AlexGershman/temp-sensor/README.md

# temp-sensor
This repo is dedicated to storing the schematic, layout, and symbol files of the temperature sensor circuit board for ECE 115D.
