AlexGershman/temp-sensor/cad/README.md

In the CAD folder, we store files such as the BOM, schematic, board, and any new symbols.
