AlexGershman/temp-sensor/sim/LTSpice/ECE_115D_555_Timer_IC.asc

A1: srflop; cycles=2
A2: inv
C1: cap; 1µ; V=16 Irms=0 Rser=0 Lser=0
C2: cap; 0.01µ; V=16 Irms=0 Rser=0 Lser=0
C3: cap; 0.01µ
C4: Cap; 10µ
E5: e; 316000
Q1: npn; QNPN_THAT_NS
Q2: npn; QNPN_THAT_NS
Q3: npn; QNPN_THAT_NS
Q4: npn; QNPN_THAT_NS
Q5: pnp; QPNP_THAT_NS
Q6: pnp; QPNP_THAT_NS
Q7: pnp; QPNP_THAT_NS
Q8: pnp; QPNP_THAT_NS
Q9: pnp; QPNP_THAT_NS
Q10: pnp; QPNP_THAT_NS
Q11: pnp; QPNP_THAT_NS
Q12: pnp; QPNP_THAT_NS
Q13: npn; QNPN_THAT_NS
R1: res; 40k
R3: res; 1k
R4: res; 1k
R5: res; 5k
R8: Res; 765
R9: Res; 500
R10: Res; 10000
R_vbe: res; 1.85k
RPTAT: res; 100
TRIG: voltage; PULSE(5 0 2m 0 0 50u 10m 3)
U1: NE555
U2: NE555
U3: AD8551
U5: AD8551
U6: AD8551
V1: voltage; 5
V2: voltage; 5
V3: Voltage; 6
V4: voltage; 5
Named nets: 0, Vbe, BG, PTAT, VCC, TRIG, THR_DISC, OUT, V_PTAT, FREQ_THR, FREQ_OUT, COUNT, V_BG, LDOout, VSW, FREQ_CTRL
.include lib/THAT_Models/300_Series_Macro_01.lib
.MODEL QNPN_THAT_NS NPN (
+ IS     = 5.005475E-15    BF     = 150
+ NF     = 1               BR     = 119.4532856 
+ NR     = 1               ISE    = 3.002016E-16    NE     = 1.3340565
+ ISC    = 3.173175E-14    NC     = 1.6525          VAF    = 60
+ VAR    = 10.8094728      IKF    = 0.2850543       IKR    = 0.0103675
+ RB      = 30             RBM     = 2.94235        IRB    = 1.750788E-4
+ RE     = 0.2             RC     = 12.4561714      CJE    = 5.086292E-12
+ VJE    = 0.7241957       MJE    = 0.49456         FC     = 0.97
+ CJC    = 2.190824E-12    VJC    = 0.5595858       MJC    = 0.498675
+ TF     = 7.063932E-11    XTF    = 17.846692       ITF    = 0.0862198
+ VTF    = 1.7447209       QCO     = 1E-12          RCO    = 1
+ VO      = 1              GAMMA   = 1E-13          XTB    = 1.1
+ PTF              = 20)
.MODEL QPNP_THAT_NS PNP (
+ IS     = 2.330327E-15    BF     = 80
+ NF     = 0.998           BR     = 54.6051301
+ NR     = 1               ISE    = 6.471784E-14    NE     = 1.5256667
+ ISC    = 9.821992E-14    NC     = 1.4090231       VAF    = 50
+ VAR    = 8.5915034       IKF    = 0.1605012       IKR    = 2.997951E-3
+ RB     = 25              RBM    = 1.604356        IRB    = 1.3734E-4
+ RE     = 0.2             RC     = 17.9803001      CJE    = 5.921046E-12
+ VJE    = 0.7302802       MJE    = 0.49864         FC     = 0.9317095
+ CJC    = 3.374991E-12    VJC    = 0.6162124       MJC    = 0.497456
+ TF     = 2.416792E-10    XTF    = 5.9184348       ITF    = 0.0726275
+ VTF    = 1.2378779       QCO     = 1E-12          RCO    = 1
+ VO     = 1               GAMMA   = 1E-13          XTB    = 1.2
+ PTF              = 20)
.tran 0 30m 5m
.temp 55
.noise V(LDOout) V3 dec 100 1 100k
.step temp -20 85 1
