AlexGershman/temp-sensor/cad/temp-sensor.brd

## EAGLE design cad/temp-sensor.brd (2024-05-08)

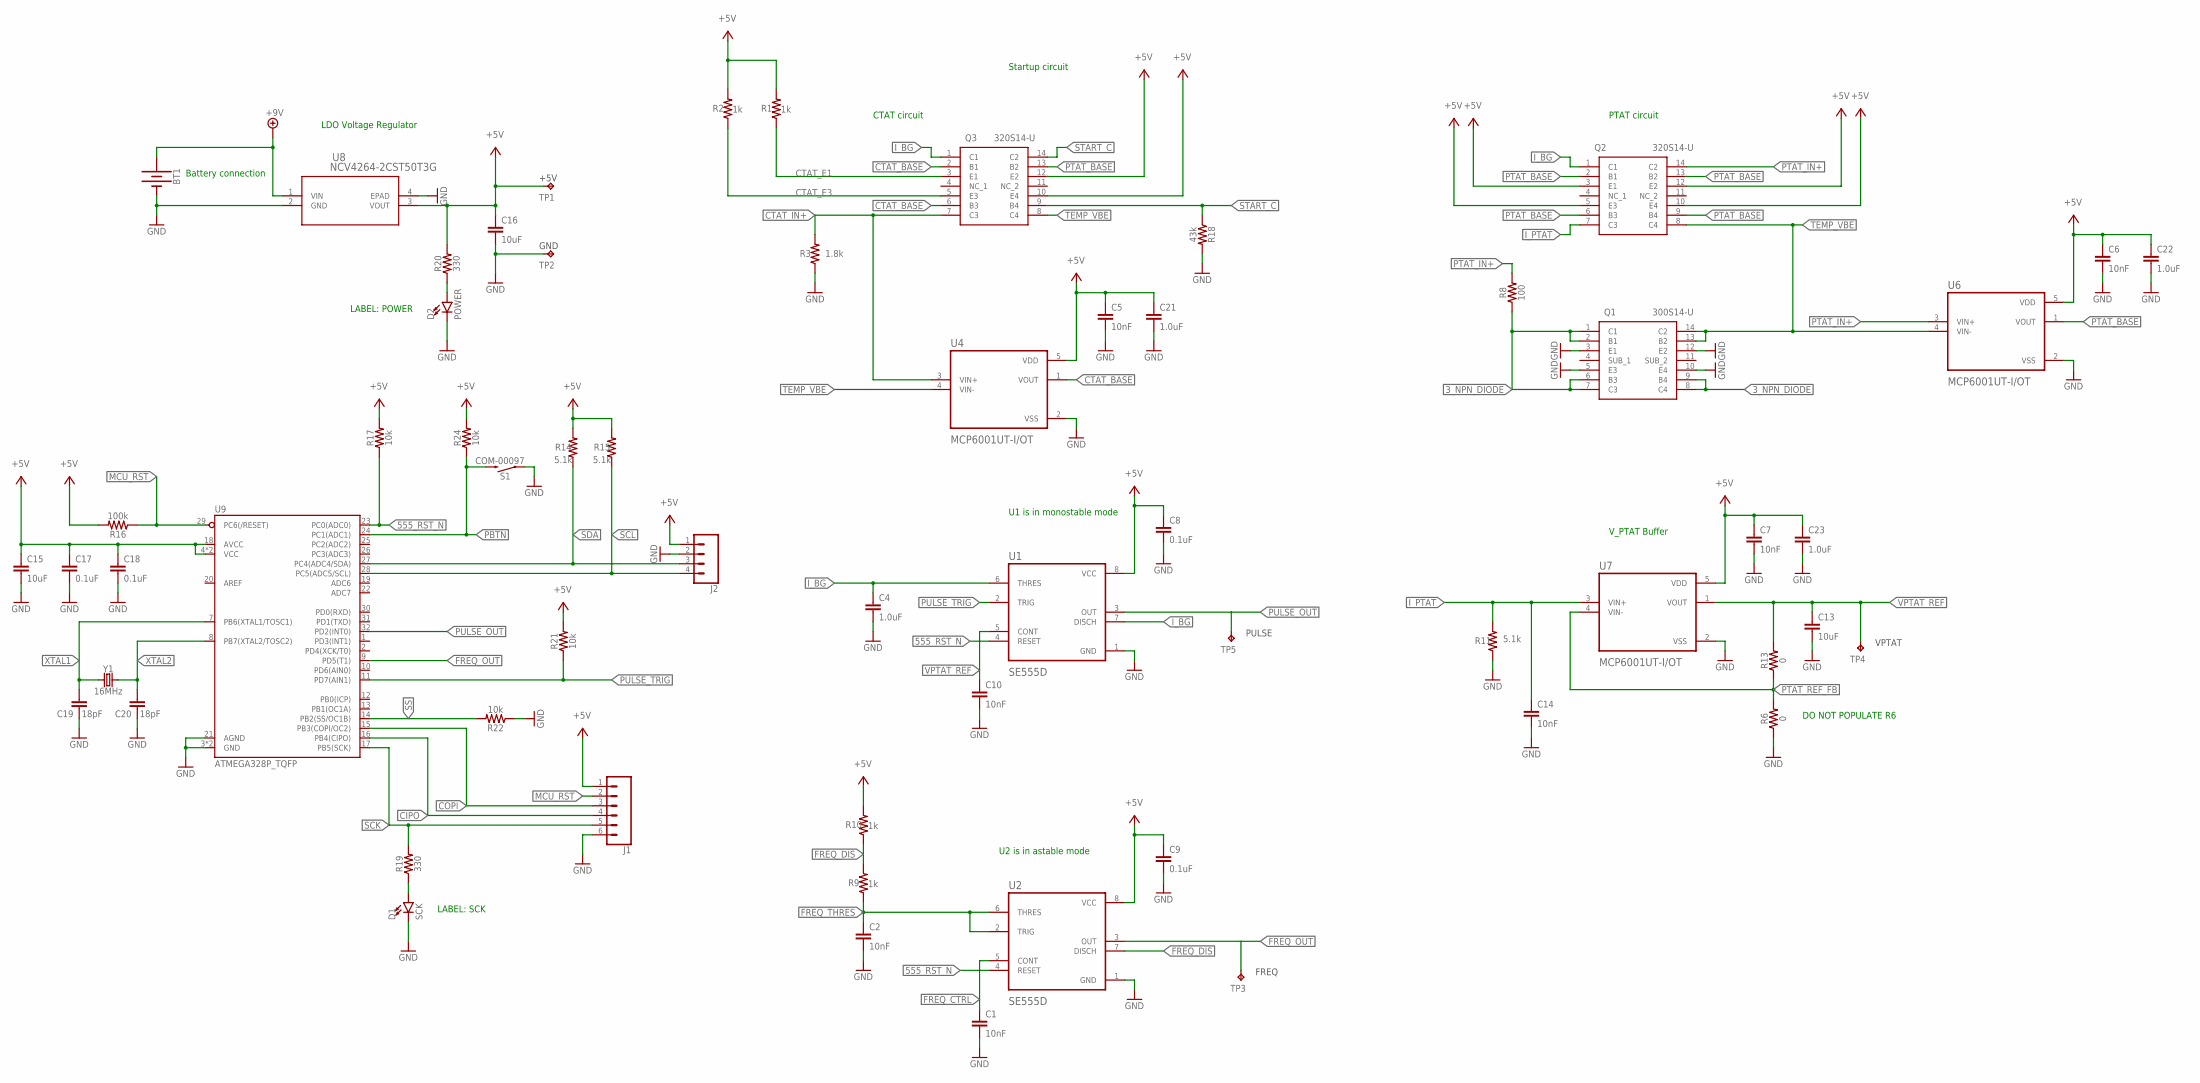
[picture p1: schematic temp-sensor.sch]

Parts:
BT1: BATTERY-9V; BATTCON_9V
C1, C2, C5, C6, C7, C10, C14: 10nF; 0603
C4, C21, C22, C23: 1.0uF; 0603
C8, C9, C17, C18: 0.1uF; 0603
C13, C15, C16: 10uF; 0805
C19, C20: 18pF; 0603
D1: SCK; LED-1206
D2: POWER; LED-1206
J1: CONN_06SILK_FEMALE_PTH; 1X06
J2: CONN_04PTH; 1X04
Q1: 300S14-U; SOIC127P602X175-14N
Q2, Q3: 320S14-U; SOIC127P602X175-14N
R1, R2, R9, R10: 1k; 0603
R3: 1.8k; 0603
R6, R13: 0; 0603
R8: 100; 0603
R11, R14, R15: 5.1k; 0603
R16: 100k; 0603
R17, R21, R22, R24: 10k; 0603
R18: 43k; 0603
R19, R20: 330; 0603
S1: MOMENTARY-SWITCH-SPST-PTH-6.0MM; TACTILE_SWITCH_PTH_6.0MM
TP1, TP2, TP3, TP4, TP5: TPPAD1-13; P1-13
U1, U2: SE555D; SOIC127P599X175-8N
U4, U6, U7: MCP6001UT-I/OT; SOT95P270X145-5N
U8: NCV4264-2CST50T3G; SOT-223_ONS
U9: ATMEGA328P_TQFP; TQFP32-08
Y1: 16MHz; CRYSTAL-SMD-5X3.2-4PAD

Connections:
3_NPN_DIODE: Q1.1 (C1), Q1.2 (B1), Q1.6 (B3), Q1.7 (C3), Q1.8 (C4), Q1.9 (B4), R8.1
555_RST_N: R17.1, U1.4 (RESET), U2.4 (RESET), U9.23 (PC0(ADC0))
+5V: C5.1, C6.1, C7.1, C8.1, C9.1, C15.1, C16.1, C17.1, C18.1, C21.1, C22.1, C23.1, J1.1, J2.1, Q2.3 (E1), Q2.5 (E3), Q2.10 (E4), Q2.12 (E2), Q3.10 (E4), Q3.12 (E2), R1.2, R2.2, R10.2, R14.2, R15.2, R16.2, R17.2, R20.2, R21.2, R24.2, TP1.TP, U1.8 (VCC), U2.8 (VCC), U4.5 (VDD), U6.5 (VDD), U7.5 (VDD), U8.3 (VOUT), U9.4 (VCC), U9.6 (VCC), U9.18 (AVCC)
+9V: BT1.+, U8.1 (VIN)
CIPO: J1.4, U9.16 (PB4(CIPO))
COPI: J1.3, U9.15 (PB3(COPI/OC2))
CTAT_BASE: Q3.2 (B1), Q3.6 (B3), U4.1 (VOUT)
CTAT_E1: Q3.3 (E1), R1.1
CTAT_E3: Q3.5 (E3), R2.1
CTAT_IN+: Q3.7 (C3), R3.2, U4.3 (VIN+)
FREQ_CTRL: C1.1, U2.5 (CONT)
FREQ_DIS: R9.2, R10.1, U2.7 (DISCH)
FREQ_OUT: TP3.TP, U2.3 (OUT), U9.9 (PD5(T1))
FREQ_THRES: C2.1, R9.1, U2.2 (TRIG), U2.6 (THRES)
GND: BT1.-, C1.2, C2.2, C4.2, C5.2, C6.2, C7.2, C8.2, C9.2, C10.2, C13.2, C14.2, C15.2, C16.2, C17.2, C18.2, C19.1, C20.1, C21.2, C22.2, C23.2, D1.C, D2.C, J1.6, J2.2, Q1.3 (E1), Q1.5 (E3), Q1.10 (E4), Q1.12 (E2), R3.1, R6.1, R11.1, R18.2, R22.1, S1.1, TP2.TP, U1.1 (GND), U2.1 (GND), U4.2 (VSS), U6.2 (VSS), U7.2 (VSS), U8.2 (GND), U8.4 (EPAD), U9.3 (GND), U9.5 (GND), U9.21 (AGND)
I_BG: C4.1, Q2.1 (C1), Q3.1 (C1), U1.6 (THRES), U1.7 (DISCH)
I_PTAT: C14.1, Q2.7 (C3), R11.2, U7.3 (VIN+)
MCU_RST: J1.2, R16.1, U9.29 (PC6(/RESET))
unnamed: D1.A, R19.1
unnamed: D2.A, R20.1
PBTN: R24.1, S1.3 (2), U9.24 (PC1(ADC1))
PTAT_BASE: Q2.2 (B1), Q2.6 (B3), Q2.9 (B4), Q2.13 (B2), Q3.13 (B2), U6.1 (VOUT)
PTAT_IN+: Q2.14 (C2), R8.2, U6.3 (VIN+)
PTAT_REF_FB: R6.2, R13.1, U7.4 (VIN-)
PULSE_OUT: TP5.TP, U1.3 (OUT), U9.32 (PD2(INT0))
PULSE_TRIG: R21.1, U1.2 (TRIG), U9.11 (PD7(AIN1))
SCK: J1.5, R19.2, U9.17 (PB5(SCK))
SCL: J2.4, R15.1, U9.28 (PC5(ADC5/SCL))
SDA: J2.3, R14.1, U9.27 (PC4(ADC4/SDA))
SS: R22.2, U9.14 (PB2(SS/OC1B))
START_C: Q3.9 (B4), Q3.14 (C2), R18.1
TEMP_VBE: Q1.13 (B2), Q1.14 (C2), Q2.8 (C4), Q3.8 (C4), U4.4 (VIN-), U6.4 (VIN-)
VPTAT_REF: C10.1, C13.1, R13.2, TP4.TP, U1.5 (CONT), U7.1 (VOUT)
XTAL1: C19.2, U9.7 (PB6(XTAL1/TOSC1)), Y1.1
XTAL2: C20.2, U9.8 (PB7(XTAL2/TOSC2)), Y1.3 (2)

Notes on the sheet:
U1 is in monostable mode
Startup circuit
CTAT circuit
PTAT circuit
V_PTAT Buffer
U2 is in astable mode
DO NOT POPULATE R6
LDO Voltage Regulator
Battery connection
LABEL: POWER
LABEL: SCK

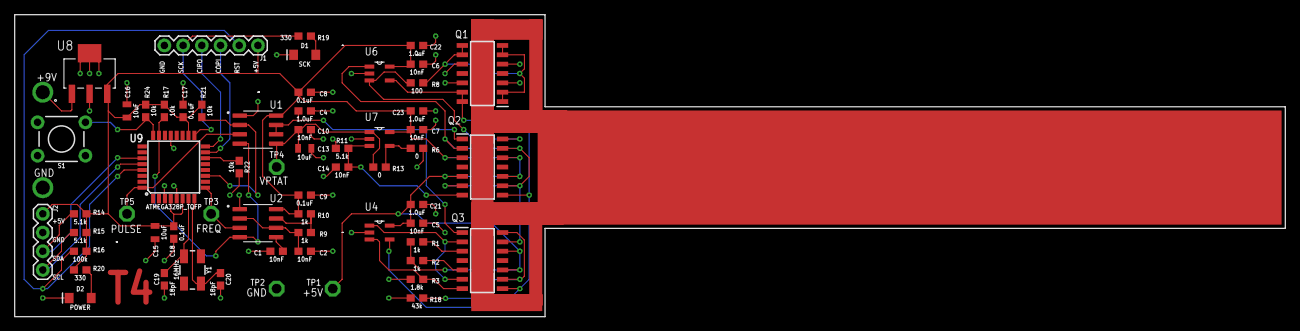
[picture p2: board temp-sensor.brd from above]

Board: 2 copper layers, 172.5 x 41.0 mm, 61 parts (1 on the bottom side), 35 nets.
