AlexGershman/temp-sensor/(commit log)

2024-04-02 Add initial LTSpice schematic
    Simulation schematic includes the Bandgap and PTAT references voltages, one 555 timer in the mono-stable mode (U1), and one 555 timer in the a-stable mode (U2). This outlines the basic architecture of our temperature measuring system.
2024-04-05 Add files via upload
    test
    [temp-sensor.sch]
2024-04-05 stuff
    add resistor
    [temp-sensor.sch]
2024-04-06 Test
    Test1 delete resistor
    [temp-sensor.sch]
2024-04-08 initialized schematic
    LTSpice implementation
    [temp-sensor.sch]
2024-04-08 Spencer's schematic additions
    [temp-sensor.sch]
2024-04-14 Adding real op-amps
    Add real op-amps to PTAT/BG circuit and their references. Needed to add a little gain to BG reference op-amp to ensure it can charge the astable timer capacitor above the 2/3 VCC (of 5V = 3.33V).
2024-04-18 Delete cad/ECE_115D_555_Timer_IC.asc
    Remove file from wrong location
2024-04-20 Add MCU and LDO, Initialize .BRD file
    [temp-sensor.brd, temp-sensor.sch]
2024-04-21 Connect MCU
    Add MCU connection to 555 timers, add correct bypass caps for opamps, add battery holder, add LEDs for PWR_ON/SCK signals, add 6-pin header for SPI programming + MCU reset
    [temp-sensor.brd, temp-sensor.sch]
2024-04-22 Added start up circuit
    [temp-sensor.sch]
2024-04-22 Initialize part placement
    [temp-sensor.sch]
2024-04-22 Initialize layout file
    [temp-sensor.brd, temp-sensor.sch]
2024-04-22 Add placement and passives
    [temp-sensor.brd]
2024-04-23 Finished Layout and schematic
    (took out C11 and C13)
    Layout can be cleaned up?
    [temp-sensor.brd, temp-sensor.sch]
2024-04-23 Finalized Schematic and Layout
    Got rid of C11 and C13 since they were causing oscillations
    [temp-sensor.brd, temp-sensor.sch]
2024-04-23 Finalized Layout
    condensed board
    [temp-sensor.brd]
2024-04-27 Edit placement
    [temp-sensor.brd, temp-sensor.sch]
2024-04-27 Edit placement again
    [temp-sensor.brd, temp-sensor.sch]
2024-04-28 Initial routing
    Still need to add test points and clean up silk screen.
    [temp-sensor.brd, temp-sensor.sch]
2024-04-28 Clean up silk and add test points
    [temp-sensor.brd, temp-sensor.sch]
2024-04-28 Add 4 pin header for OLED
    [temp-sensor.brd, temp-sensor.sch]
2024-04-29 Finishing touches on silk
    [temp-sensor.brd, temp-sensor.sch]
2024-04-29 Removed +5V power plane
    Removed +5V power plane. Instead, +5V was routed with 12 mil traces
    [temp-sensor.brd]
2024-04-30 Presentation comments
    Removed V_BG buffer. Now feeding I_BG current source to input capacitor of monostable timer. Rerouted with 6 mil traces.
    [temp-sensor.brd, temp-sensor.sch]
2024-04-30 Changes from midterm presentation
    Changes from midterm presentation including feeding mono stable timer with bandgap current source and a capacitor. This produces a linear voltage since Ic = C dV/dt.
    [temp-sensor.brd, temp-sensor.sch]
2024-05-06 Layout change for exposed copper pad
    Removed the vias and routing under Q1, Q2, Q3 matched transistors to make space for a thermally conductive exposed copper pad
    [temp-sensor.brd, temp-sensor.sch]
2024-05-07 Add files via upload
    Implemented plate extension for temperature reading
    [temp-sensor.brd]
2024-05-08 Adjust grid and via placement
    [temp-sensor.brd]
2024-05-08 Boards ordered!
    [temp-sensor.brd]
2024-05-28 init working code
    This implementation has the following characteristics
    1) Triggers the monostable timer
    2) Counts clock from astable timer
    3) Stops counting on falling edge of monostable timer
    4) Pushbutton triggers a new measurement
2024-06-01 Add sleep capability for power saving
