AlexGershman/temp-sensor/(notices)

Notices in the files:
parts and their libraries:
SparkFun-Resistors: Licensing: Creative Commons ShareAlike 4.0 International - https://creativecommons.org/licenses/by-sa/4.0
NCV4264-2CST50T3G: COPYRIGHT: Copyright (C) 2024 Ultra Librarian. All rights reserved.
